aaronzlim/WAFR/documentation/hardware/case_inner.jpg

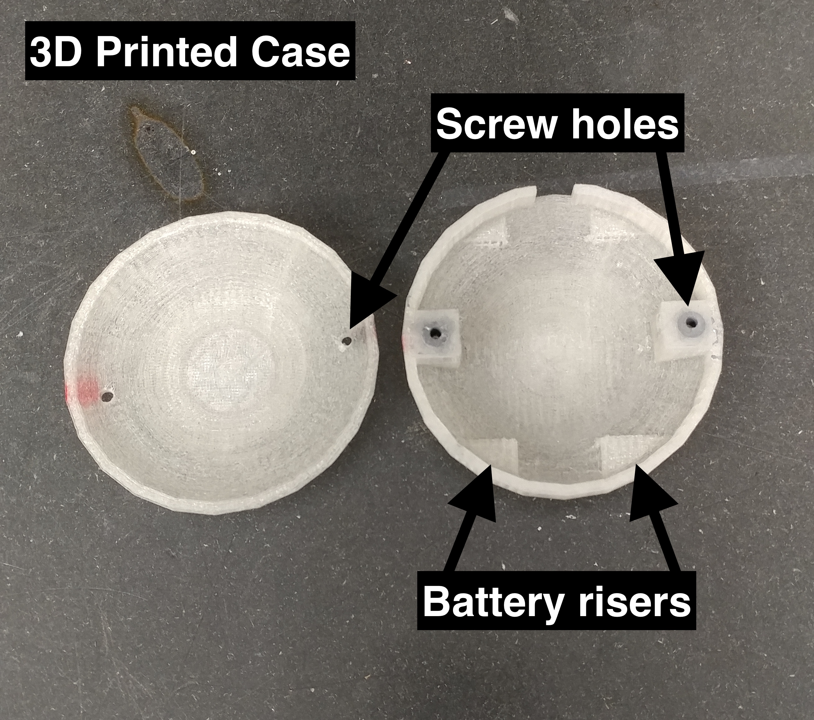
documentation/hardware/case_inner.jpg
