aaronzlim/WAFR/documentation/hardware/five_wire_cable.jpg

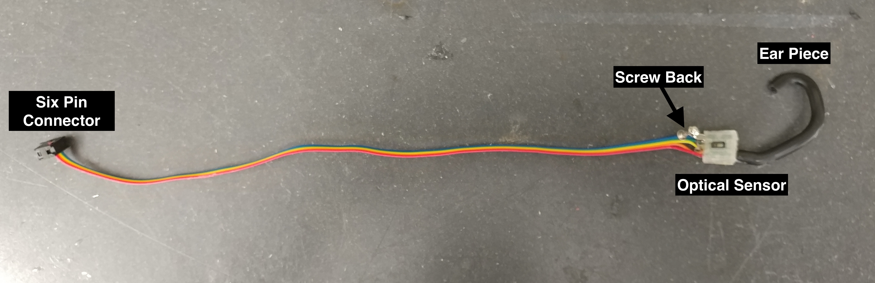
documentation/hardware/five_wire_cable.jpg
