aaronzlim/WAFR/documentation/hardware/case_side.jpg

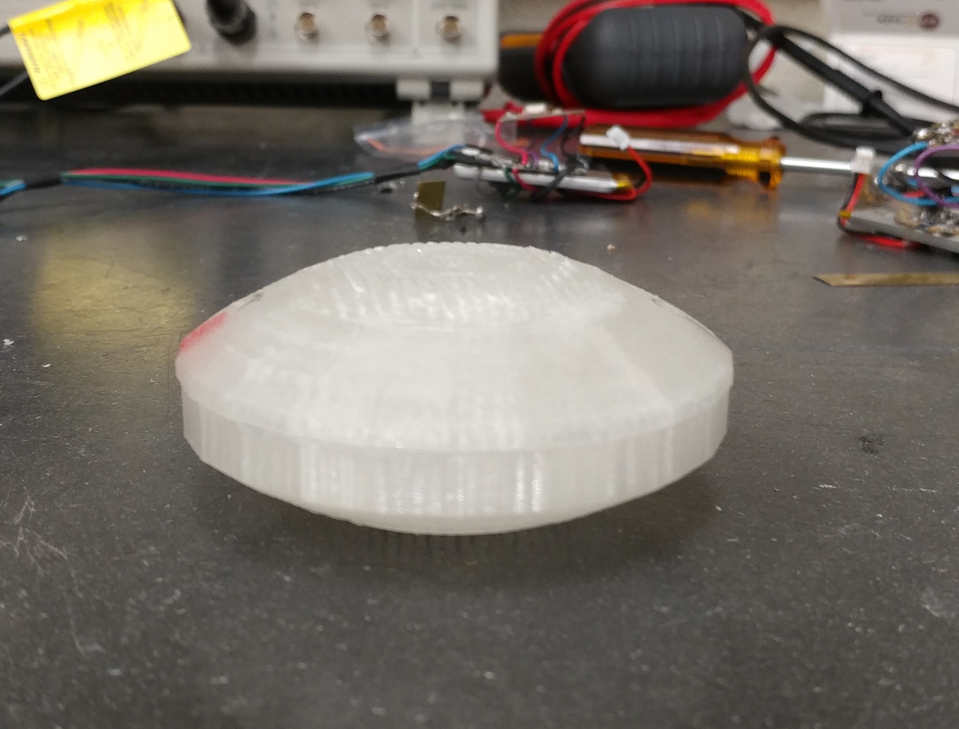
documentation/hardware/case_side.jpg
