aaronzlim/WAFR/documentation/hardware/case_top.jpg

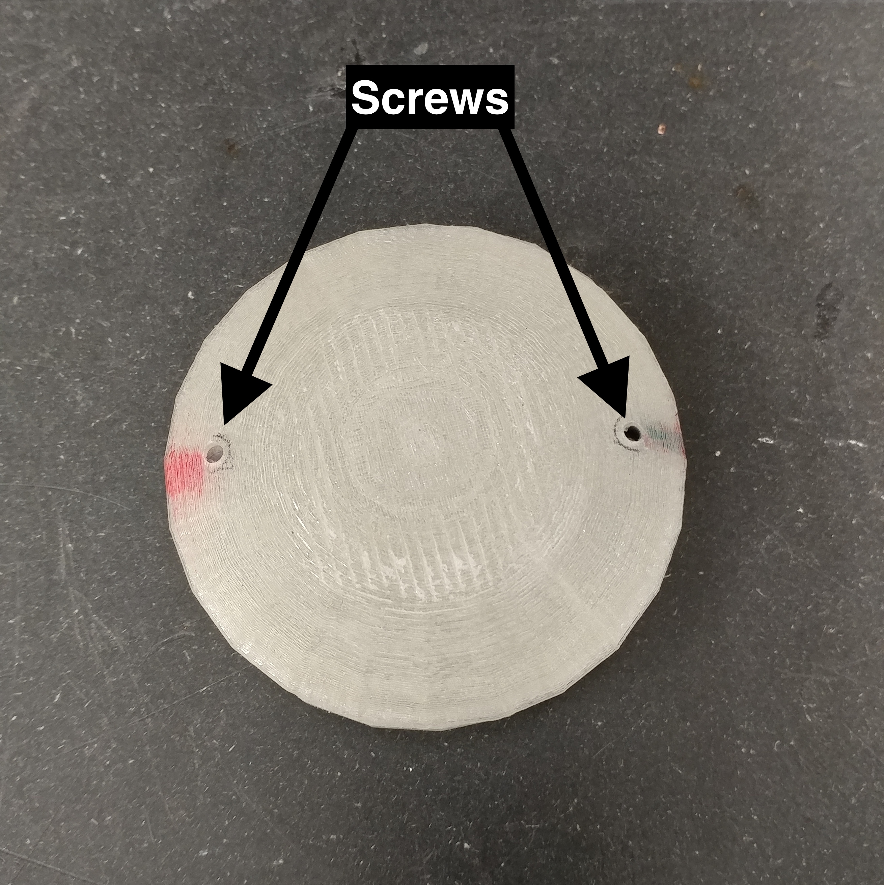
documentation/hardware/case_top.jpg
