aaronzlim/WAFR/documentation/hardware/oximeter_case_angled.jpg

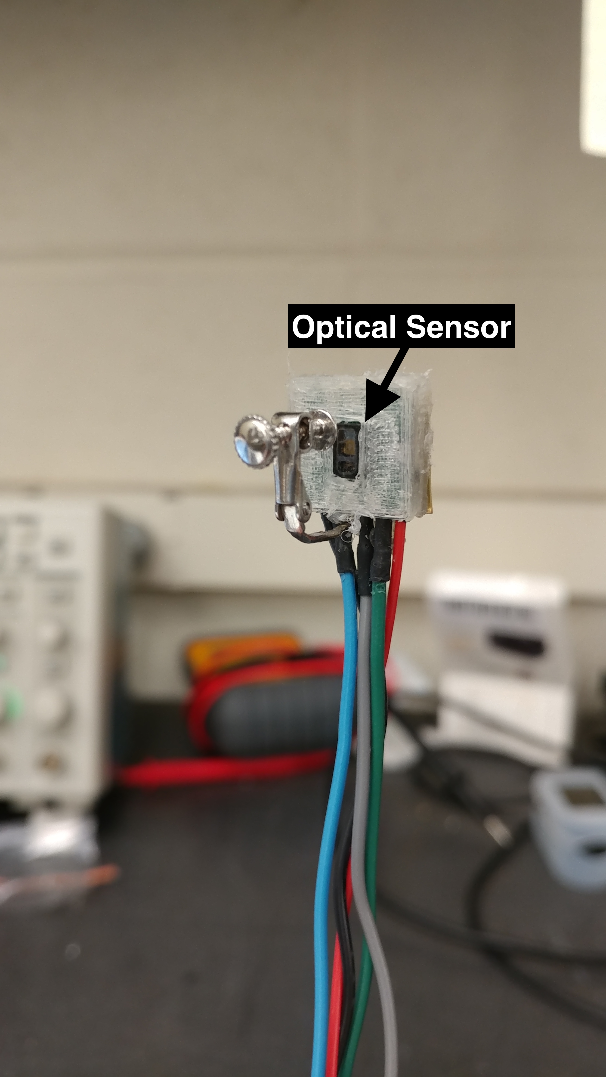
documentation/hardware/oximeter_case_angled.jpg
