aaronzlim/WAFR/documentation/hardware/oximeter_case_back.jpg

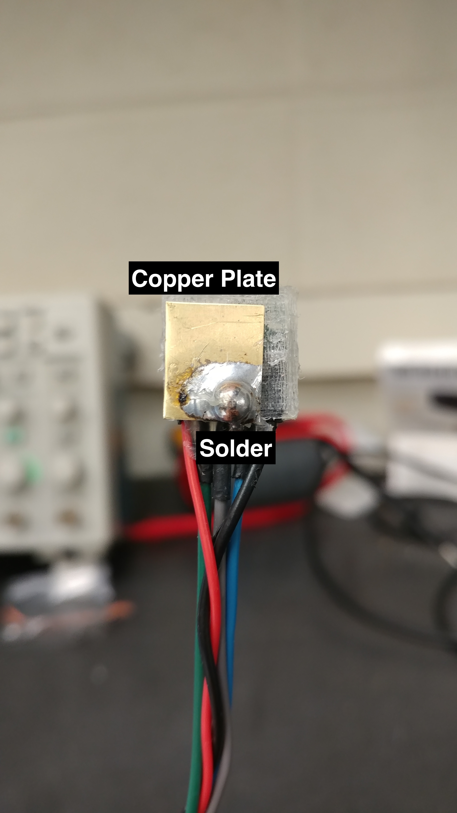
documentation/hardware/oximeter_case_back.jpg
