aaronzlim/WAFR/documentation/hardware/oximeter_case_bottom.png

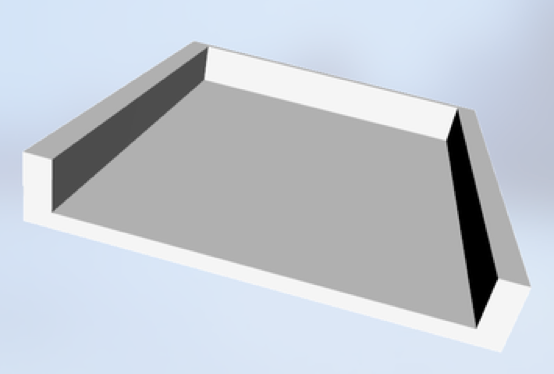
documentation/hardware/oximeter_case_bottom.png
