aaronzlim/WAFR/documentation/hardware/oximeter_case_front.jpg

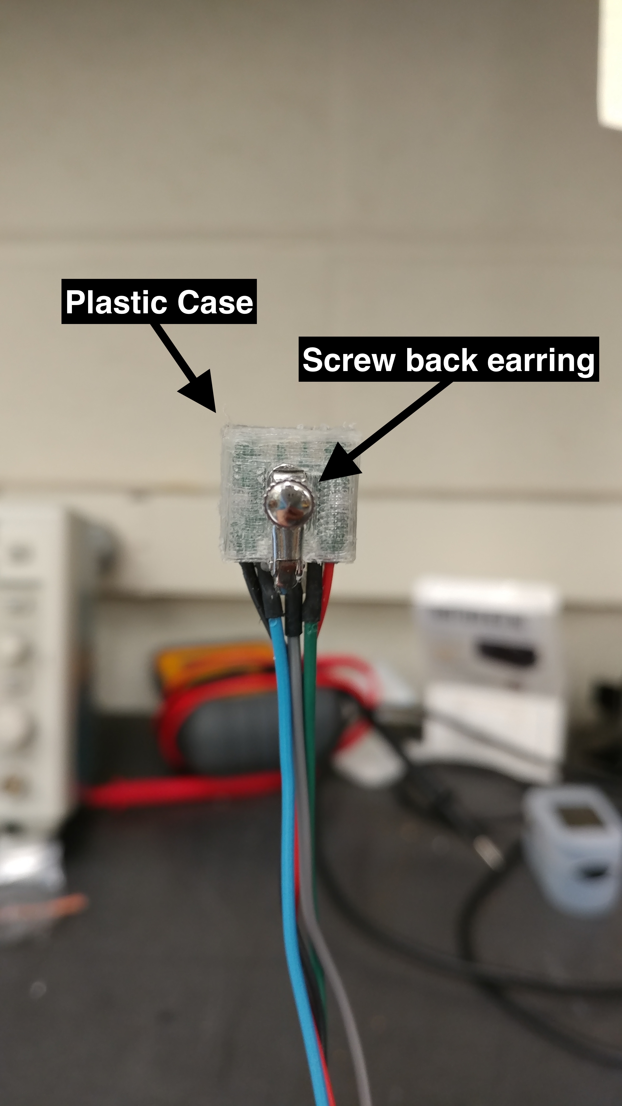
documentation/hardware/oximeter_case_front.jpg
