aaronzlim/WAFR/documentation/hardware/oximeter_case_side.jpg

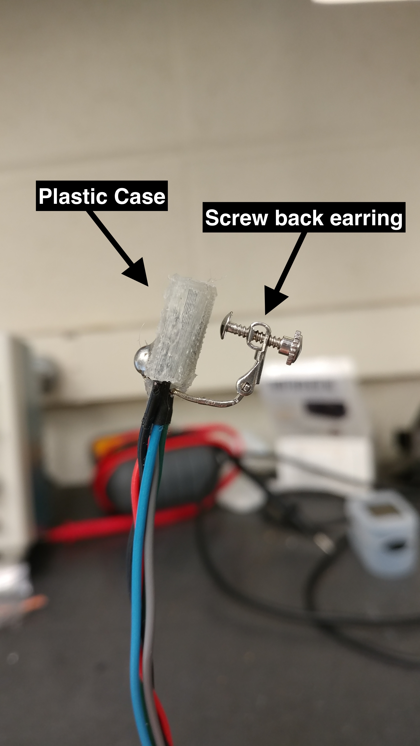
documentation/hardware/oximeter_case_side.jpg
