aaronzlim/WAFR/documentation/hardware/oximeter_case_top.png

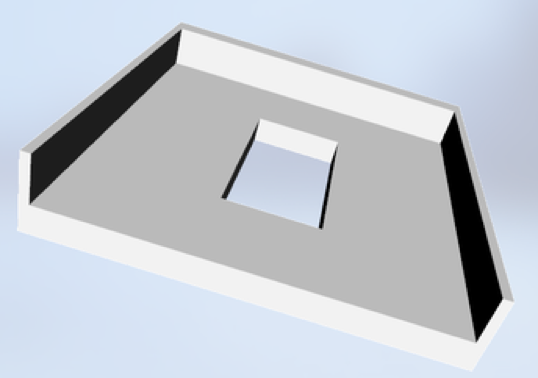
documentation/hardware/oximeter_case_top.png
