aaronzlim/WAFR/documentation/hardware/WAFR.png

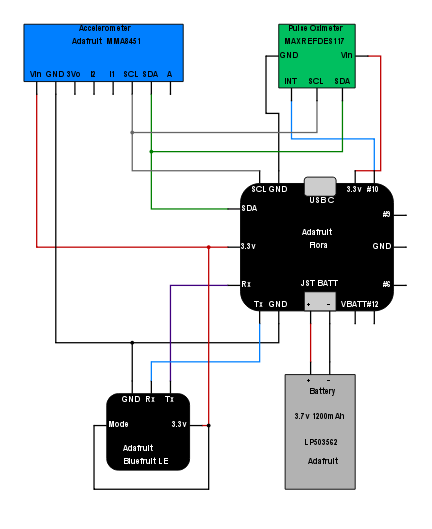
documentation/hardware/WAFR.png
