aaronzlim/WAFR/documentation/hardware/wafr_bottom.jpg

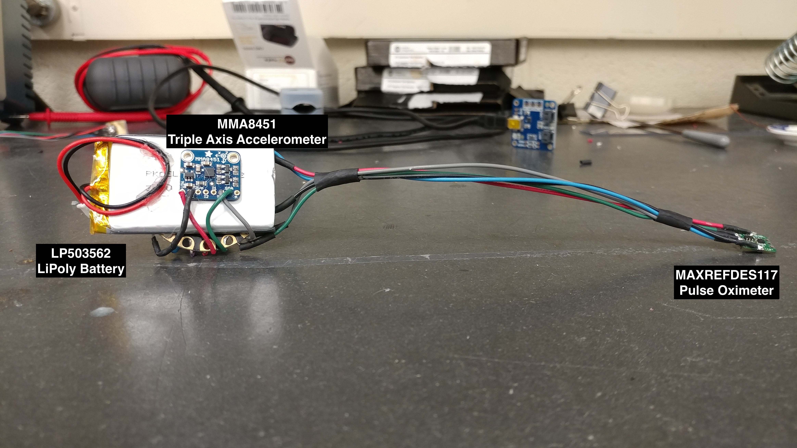
documentation/hardware/wafr_bottom.jpg
