aaronzlim/WAFR/documentation/hardware/wafr_case_bottom.png

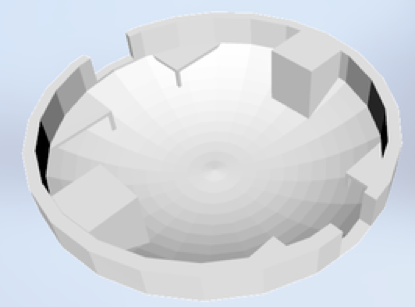
documentation/hardware/wafr_case_bottom.png
