aaronzlim/WAFR/documentation/hardware/wafr_case_top.png

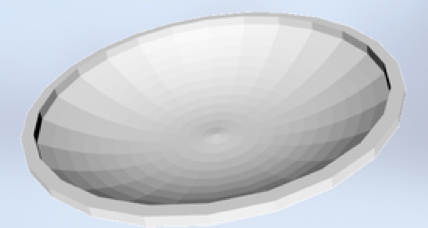
documentation/hardware/wafr_case_top.png
