aaronzlim/WAFR/documentation/hardware/wafr_side.jpg

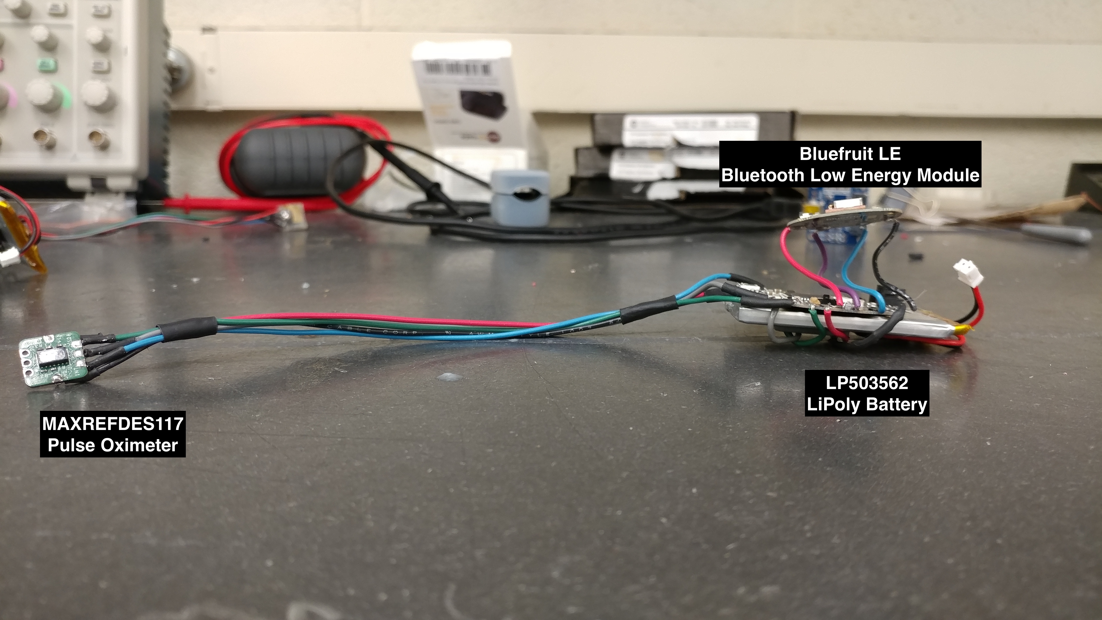
documentation/hardware/wafr_side.jpg
