aaronzlim/WAFR/documentation/hardware/wafr_top.jpg

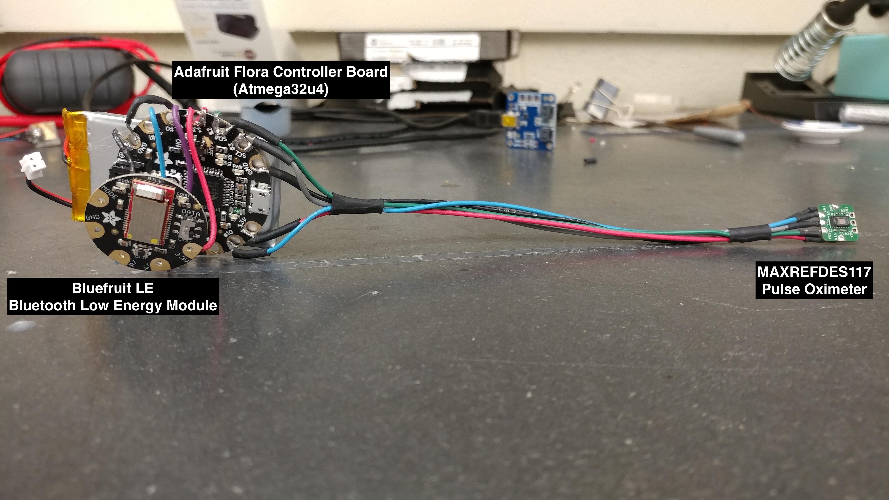
documentation/hardware/wafr_top.jpg
