aaronzlim/WAFR/documentation/software/wafr_flowcharts/ui_flowchart.png

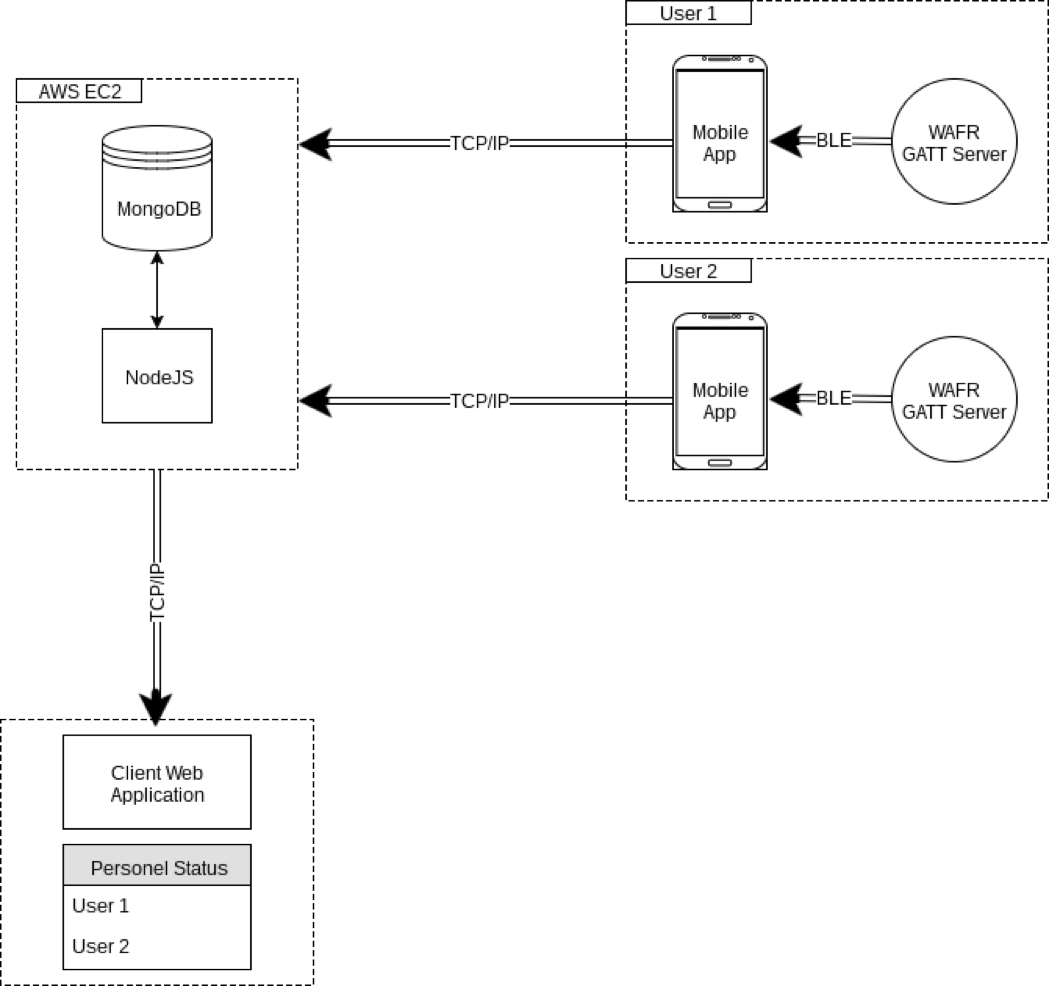
documentation/software/wafr_flowcharts/ui_flowchart.png
