aaronzlim/WAFR/matlab/figures/hr_wafr_static_04_17_06_01_jen.png

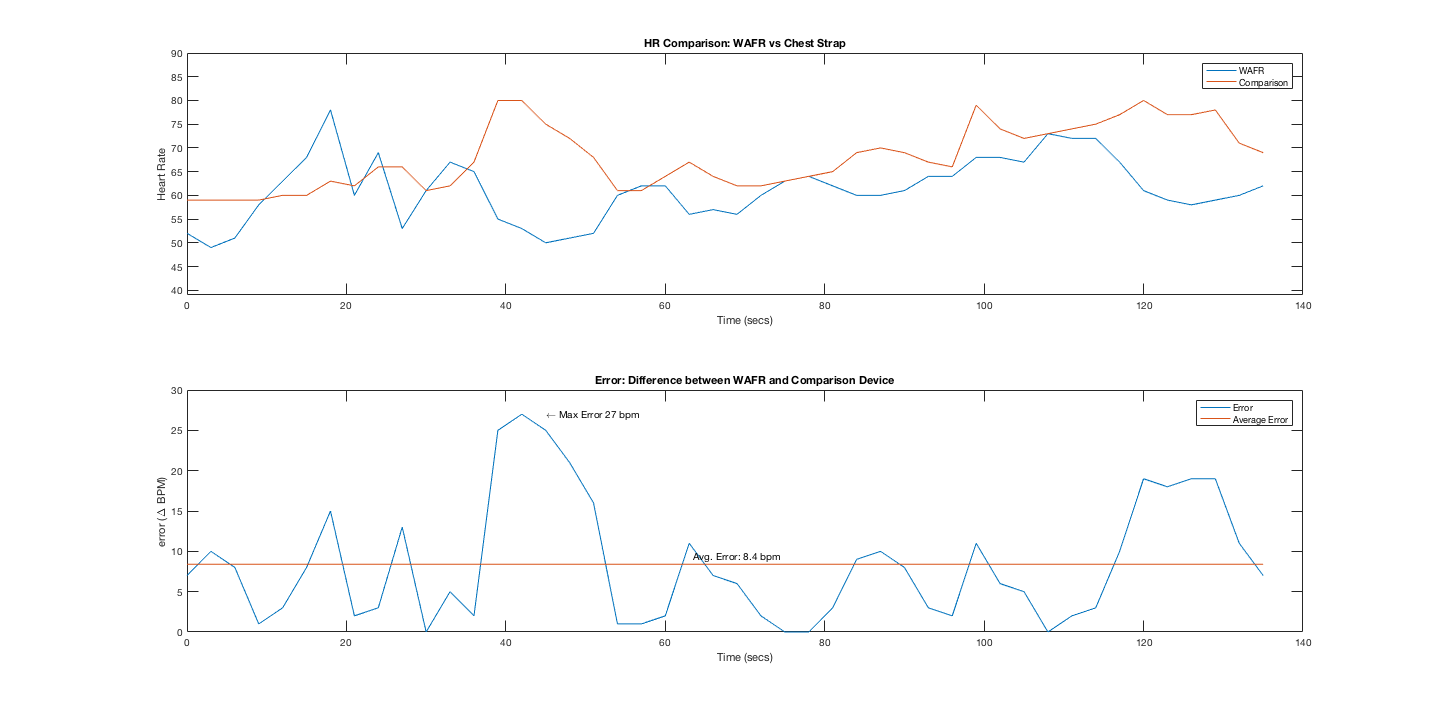
matlab/figures/hr_wafr_static_04_17_06_01_jen.png
