aaronzlim/WAFR/matlab/figures/hr_wafr_static_04_17_06_30_aaron.png

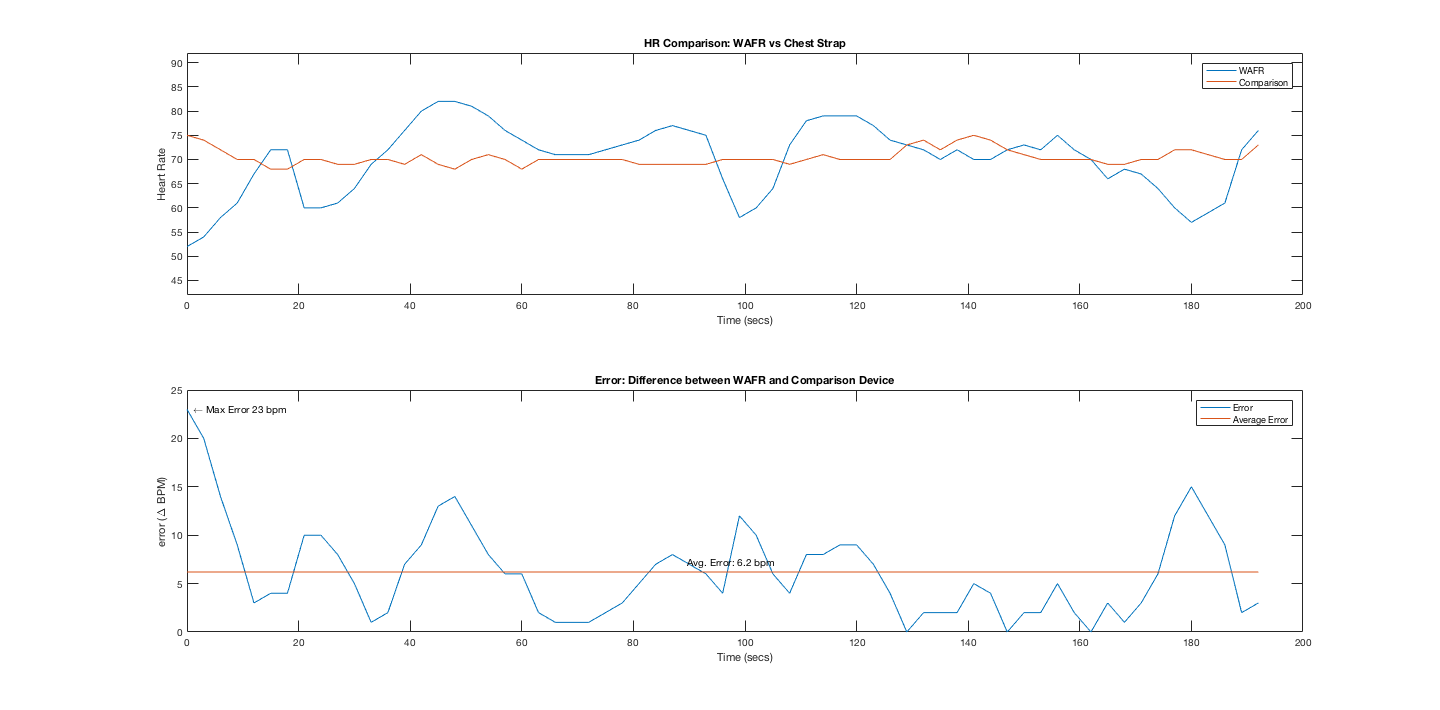
matlab/figures/hr_wafr_static_04_17_06_30_aaron.png
