aaronzlim/WAFR/matlab/figures/hr_wafr_static_04_19_04_15_aaron.png

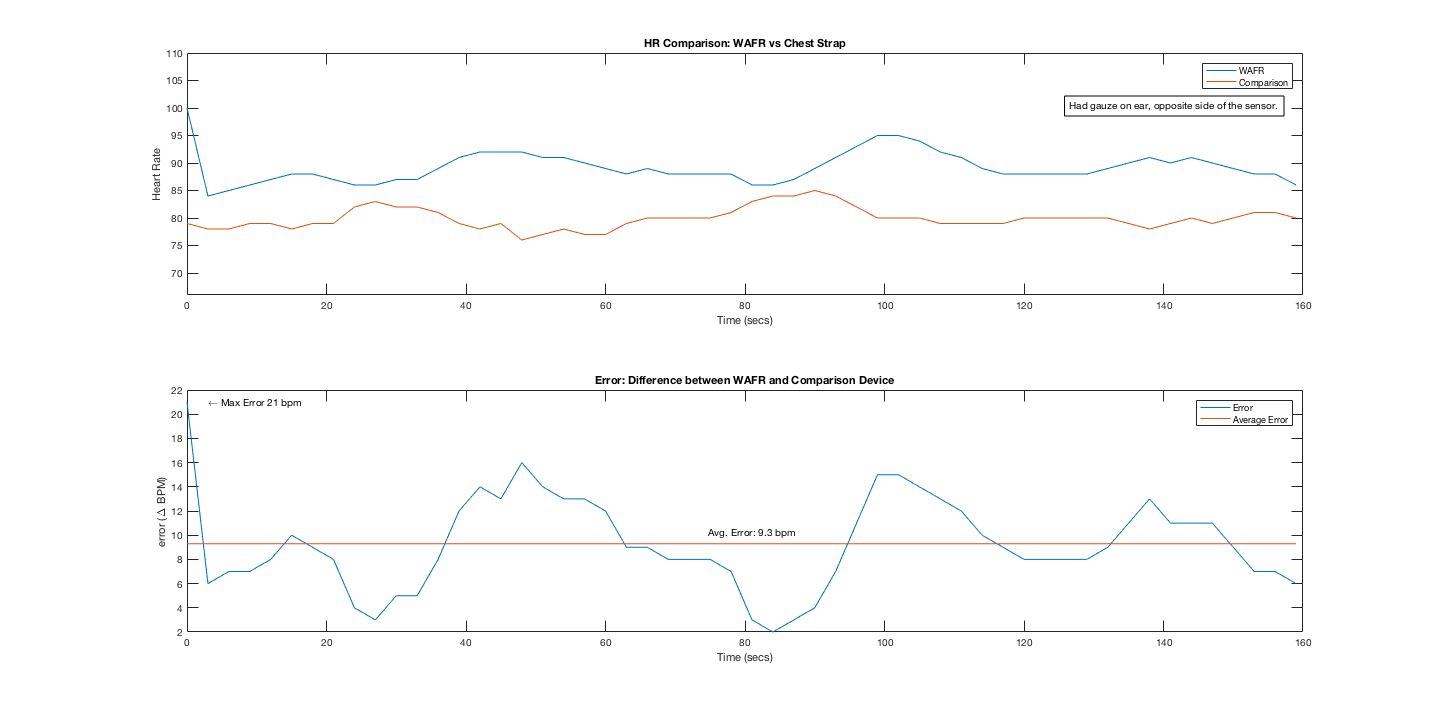
matlab/figures/hr_wafr_static_04_19_04_15_aaron.png
