aaronzlim/WAFR/matlab/figures/hr_wafr_static_04_19_05_05_aaron.png

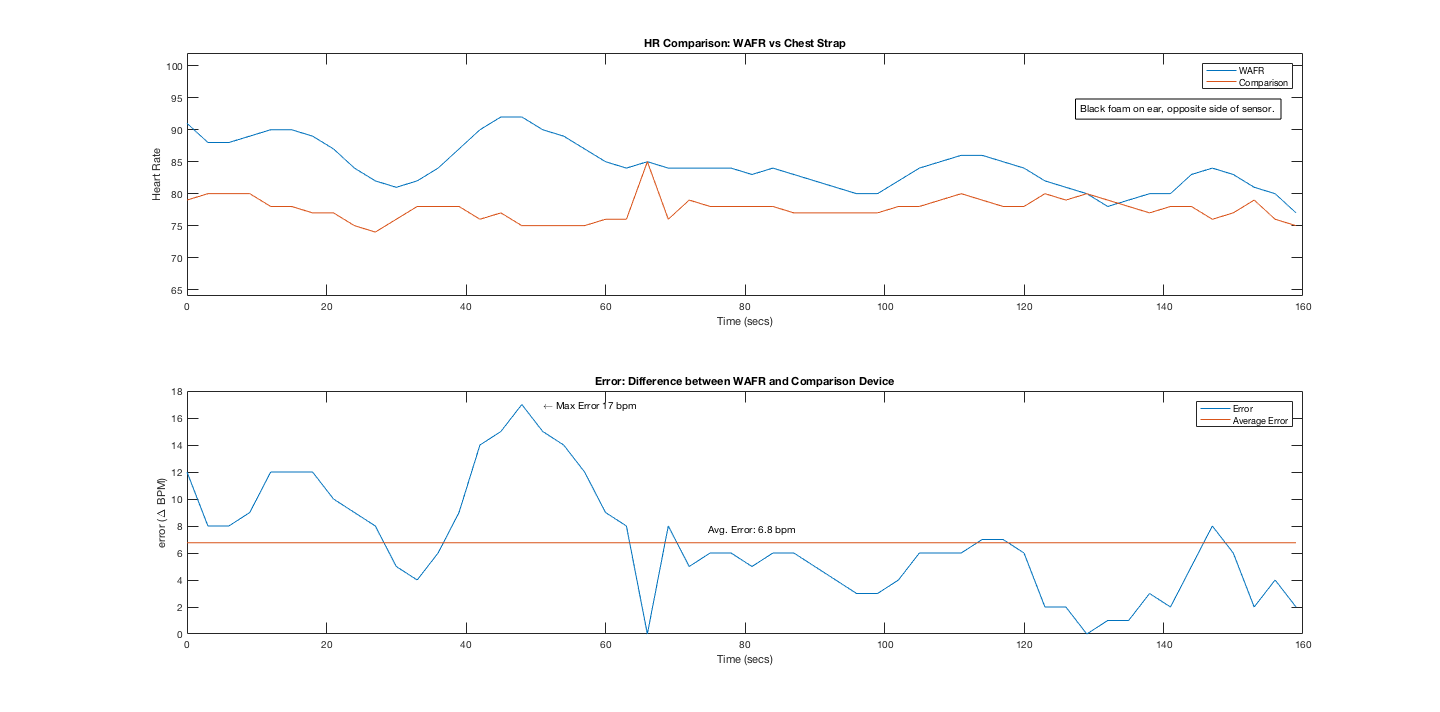
matlab/figures/hr_wafr_static_04_19_05_05_aaron.png
