aaronzlim/WAFR/matlab/figures/hr_wafr_static_04_19_05_31_aaron.png

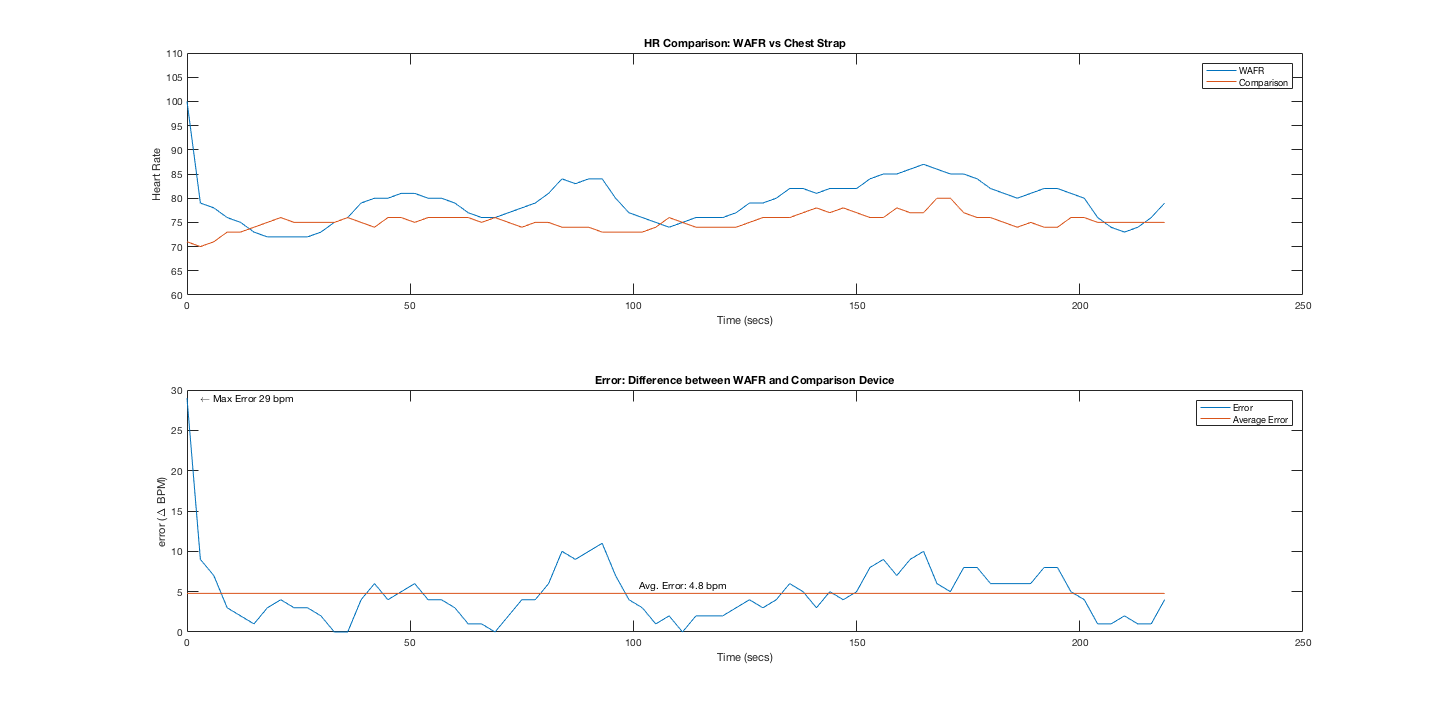
matlab/figures/hr_wafr_static_04_19_05_31_aaron.png
