aaronzlim/WAFR/matlab/figures/hr_wafr_static_04_19_05_31_aaron_edited.png

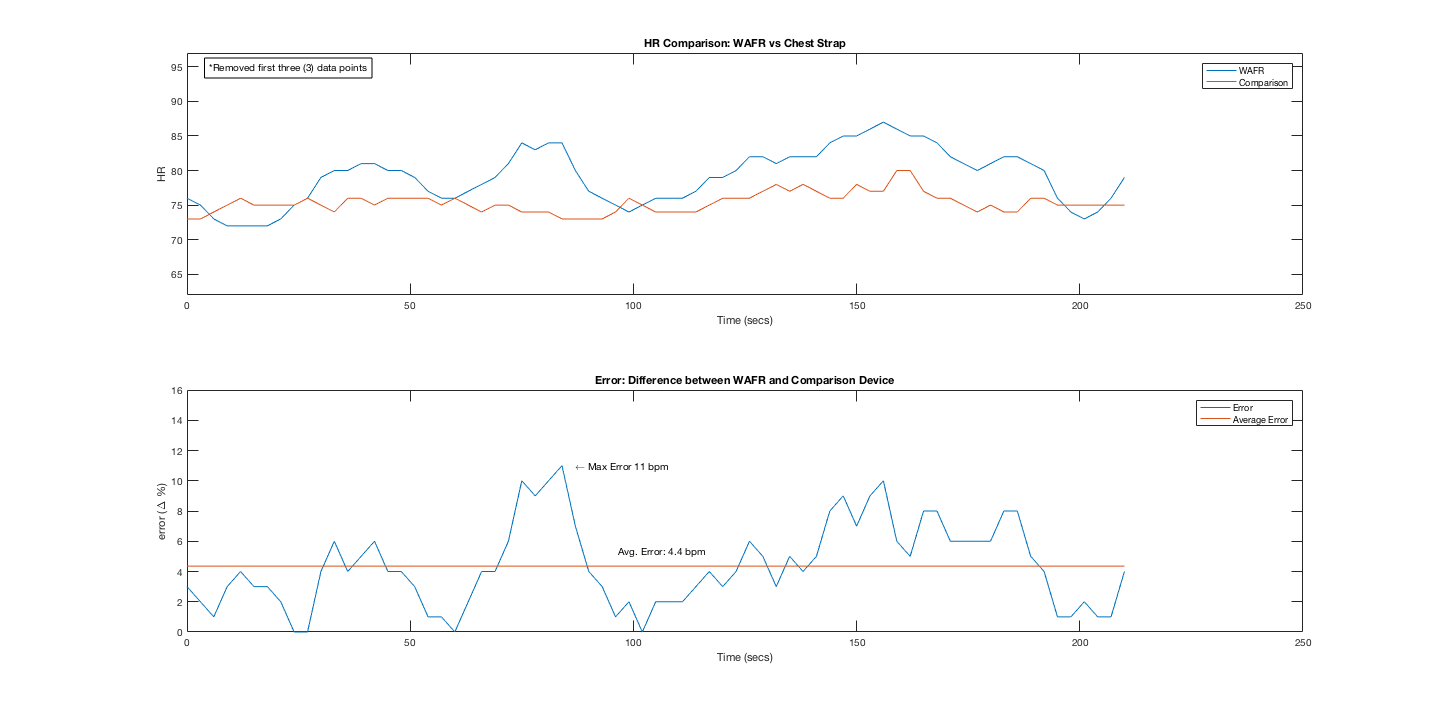
matlab/figures/hr_wafr_static_04_19_05_31_aaron_edited.png
