aaronzlim/WAFR/matlab/for_poster/hr_wafr_dynamic_04_17_06_30_aaron.png

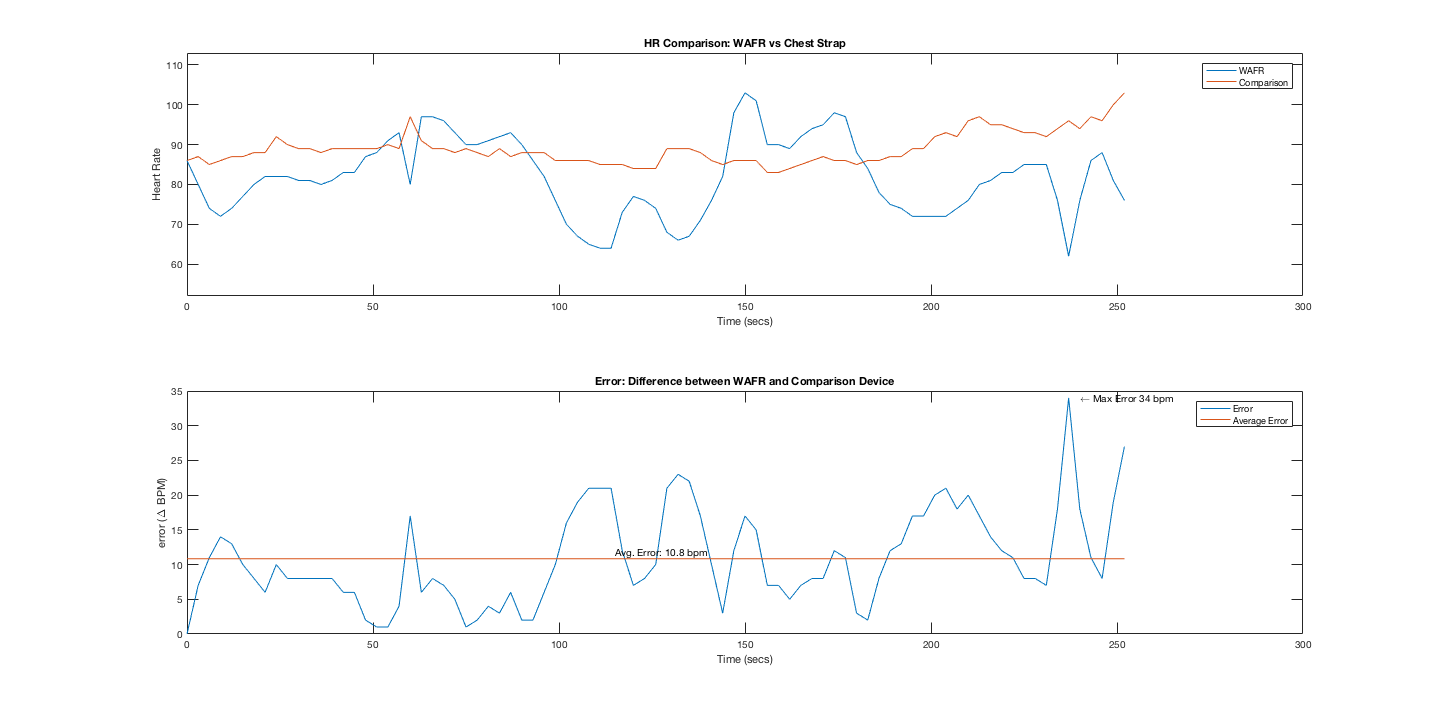
matlab/for_poster/hr_wafr_dynamic_04_17_06_30_aaron.png
