aaronzlim/WAFR/matlab/for_poster/hr_wafr_static_04_19_04_06_aaron_edited.png

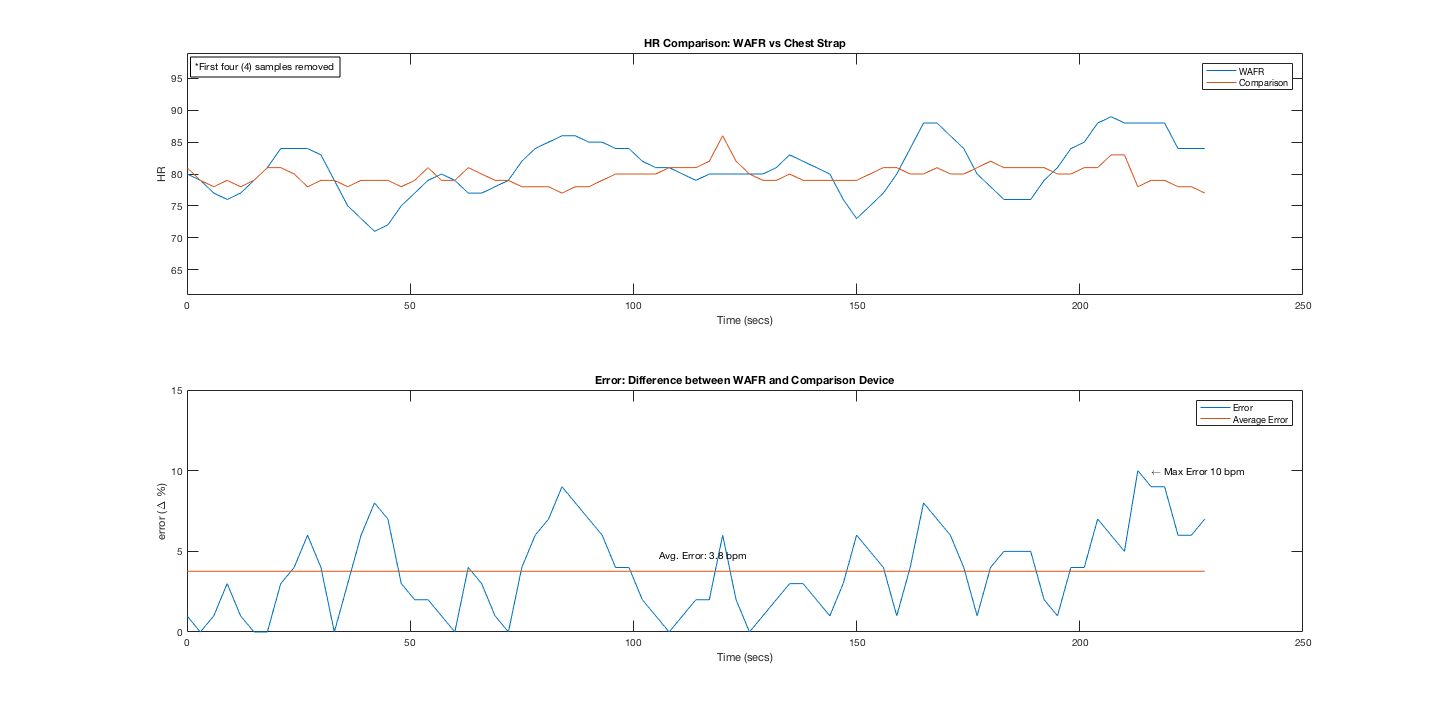
matlab/for_poster/hr_wafr_static_04_19_04_06_aaron_edited.png
