aaronzlim/WAFR/matlab/for_poster/spo2_wafr_static_04_19_05_55_aaron.png

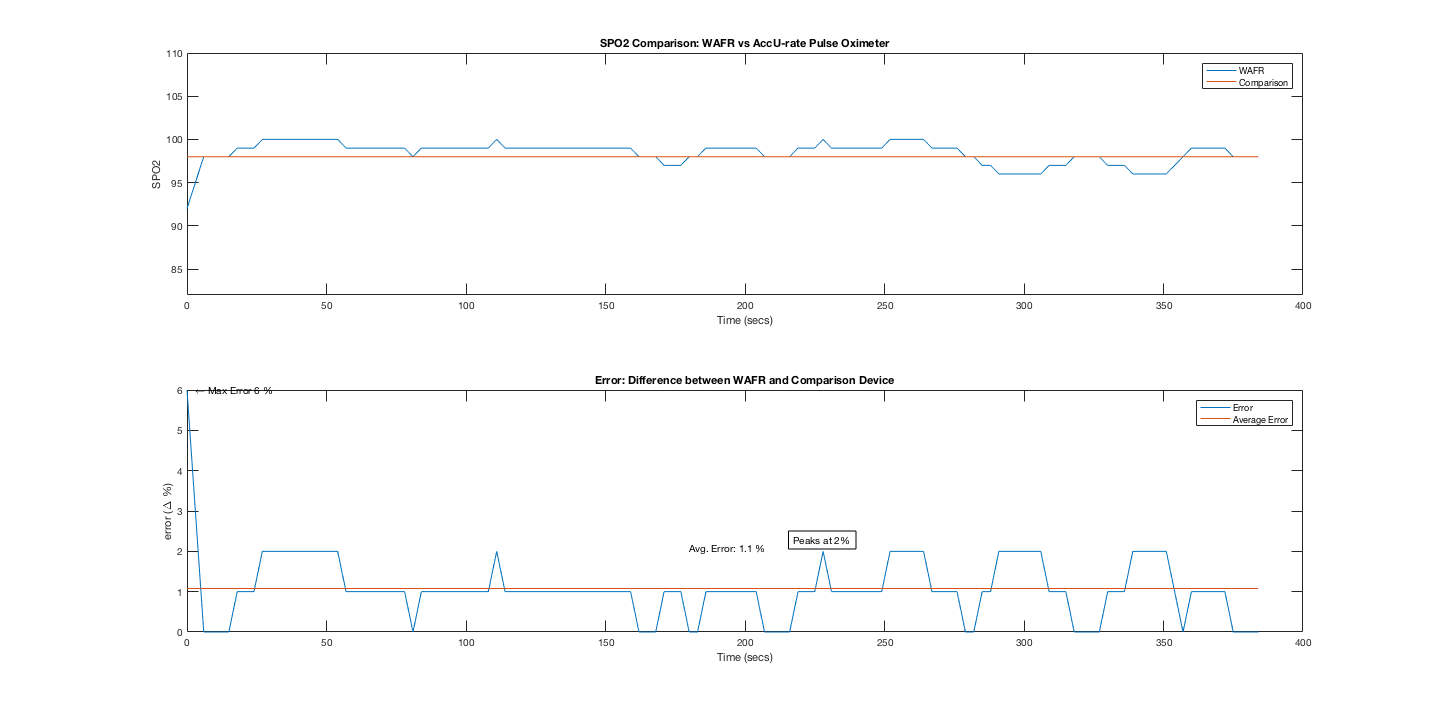
matlab/for_poster/spo2_wafr_static_04_19_05_55_aaron.png
