aaronzlim/WAFR/WAFR.png

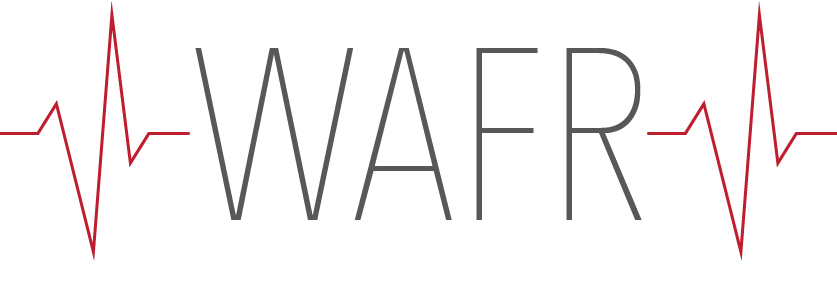
WAFR.png
