aaronzlim/WAFR/(commit log)

2017-01-30 Changed name of arduino file to maxrefdes117_dev
2017-02-03 Started work on testbench to study I2C behavior using Arduino Wire Library.
2017-02-03 Added an i2c scanner to detect devices on the bus, as well as a coupld test programs to get two of the Flora to speak to each other over i2c.
2017-02-06 Wire testing.
2017-02-10 Finished max30102 initilization and register reading code, currently debugging the spo2 and HR algorithm.
2017-02-14 Trying to port the functions in my arduino sketch into their own library.
2017-02-14 Working on smoothing max30102 data to calculate HR. Currently getting really high values.
2017-02-17 Trying to change sampling frequency to 400Hz.
2017-03-21 Dealing with HR error swings. Found data spikes when FIFO rolls over. Investigating...
    [main.cpp, max30102_processing.cpp, max30102_processing.h, max30102_wire_driver.cpp, max30102_wire_driver.h, maxrefdes117_testbench.ino, test_suite.ino]
2017-03-23 WAFR cannot pick up large jumps in heart rate. Need to fix initial avg_hr to be dynamic at first reading.
    [max30102_processing.cpp, max30102_processing.h, max30102_wire_driver.cpp, max30102_wire_driver.h, wafr.ino]
2017-03-23 Changed 4pt moving average to a 6pt moving average. Physical movement is still a big problem for the max30102 sensor...
    [max30102_processing.cpp, max30102_processing.h, maxrefdes117_testbench.ino]
2017-03-30 storing 5 HR and SPO2 samples in order to check for abnormalities.
2017-03-30 Add files via upload
    Basic sketch of accelerometer. Using Wire and Adafruit libraries. In process of rewriting libraries.
2017-03-30 Without orientation or interrupts
2017-03-30 Without orientation and interrupts
2017-04-05 The integration code is working with just the pulse oximeter and accelerometer. Need to test the bluetooth module. Also began efforts to compile documentation materials.
2017-04-06 Dealing with memory issues when all modules (oximeter, accelerometer, and ble) are connected. I think I have a working version. Needs to be tested.
    [BluefruitConfig.h, ble_test.ino, ble_testbench_max30102.ino, ble_testbench_mma8451.ino, max30102_processing.cpp, max30102_processing.h, max30102_wire_driver.cpp, max30102_wire_driver.h]
2017-04-07 updating software documentation. Assembled a prototype of the whole system and ran the code. It works, just need to play with the distress flags.
2017-04-12 Added flowcharts for the integrated wafr software.
2017-04-12 Added a wiring diagram of the WAFR system.
2017-04-13 Added accelerometer thresholds to wafr.ino, and commented out SoftwareSerial library.
